popertoelpoperon/llavero-oled/piezas/1_carcasa/carcasa.stl

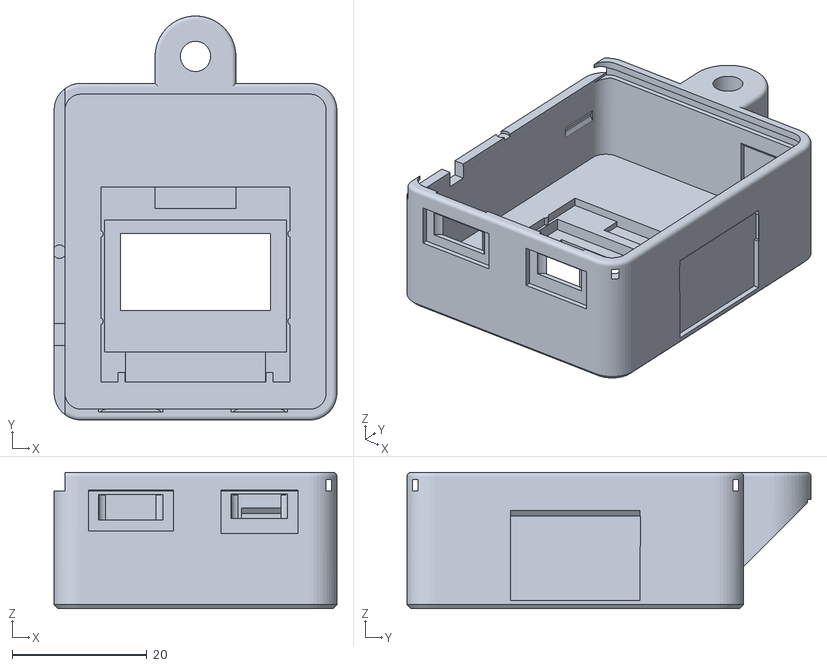
[picture p14: CAD file, 2026-11-11]
piezas/1_carcasa/carcasa.stl
42.0 x 60.0 x 20.2
