popertoelpoperon/llavero-oled/piezas/2_chasis/chasis.stl

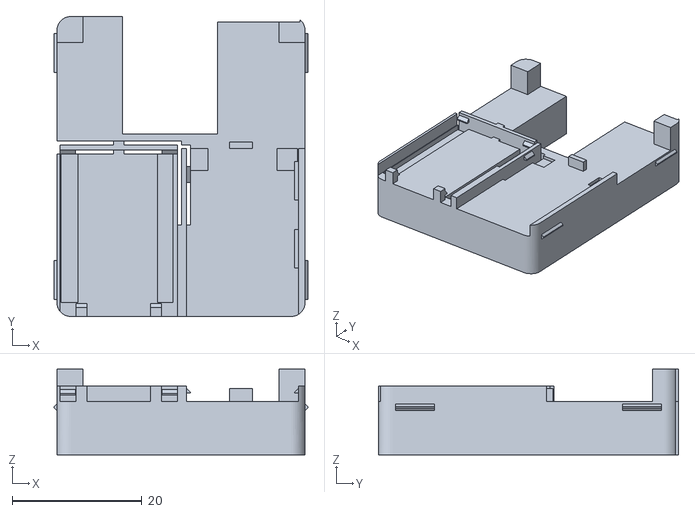
[picture p15: CAD file, 2026-11-11]
piezas/2_chasis/chasis.stl
39.2 x 46.3 x 13.2
