popertoelpoperon/llavero-oled/piezas/3_tapa/tapa_base.stl

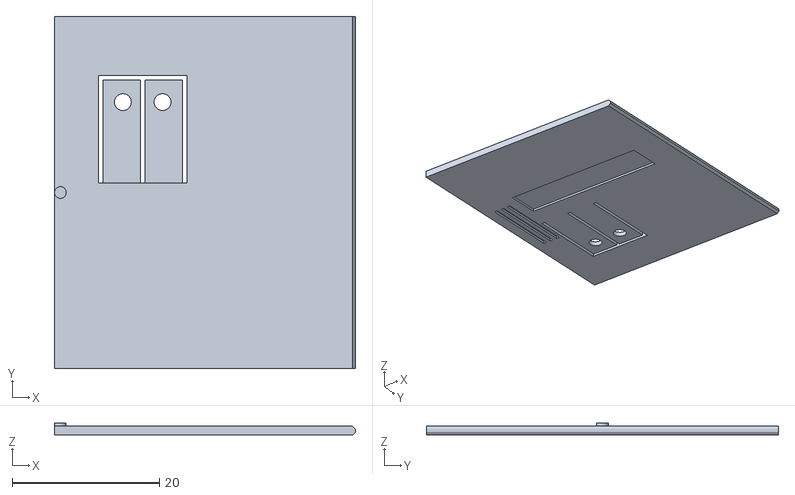
[picture p16: CAD file, 2026-11-11]
piezas/3_tapa/tapa_base.stl
40.9 x 47.9 x 1.65
