popertoelpoperon/llavero-oled/piezas/4_medallon_logo/disco_blanco.stl

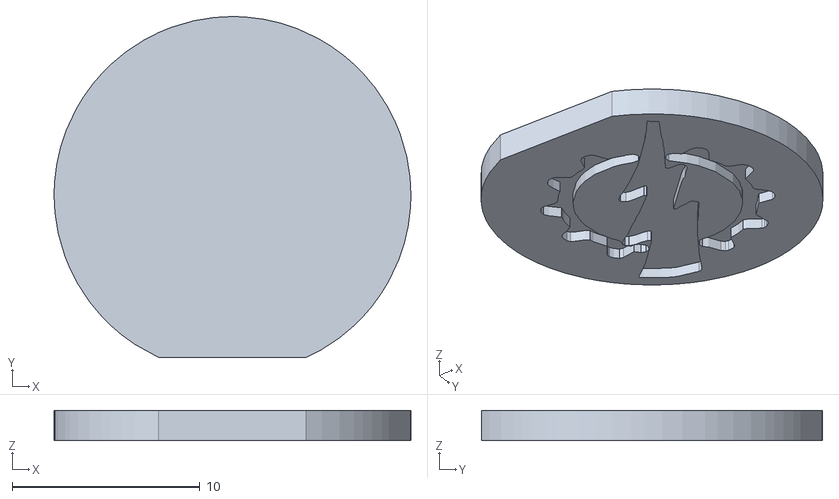
[picture p17: CAD file, 2026-11-11]
piezas/4_medallon_logo/disco_blanco.stl
19.0 x 18.2 x 1.60
