popertoelpoperon/llavero-oled/piezas/5_costado_derecho/placa.stl

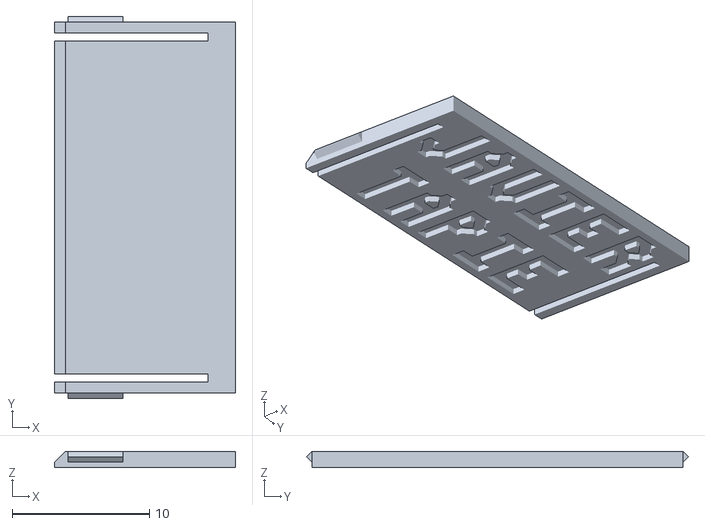
[picture p18: CAD file, 2026-11-11]
piezas/5_costado_derecho/placa.stl
13.2 x 27.8 x 1.20
