popertoelpoperon/llavero-oled/piezas/6_costado_izquierdo/texto_blanco.stl

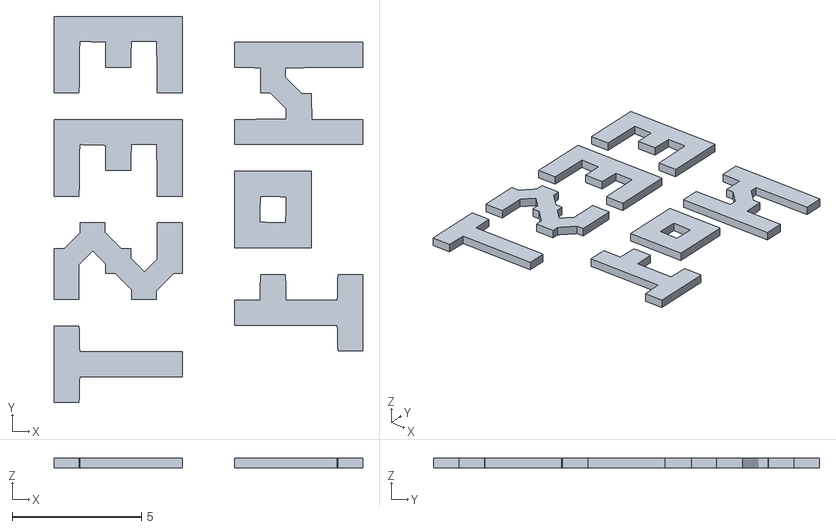
[picture p19: CAD file, 2026-11-11]
piezas/6_costado_izquierdo/texto_blanco.stl
12.0 x 15.0 x 0.4
