popertoelpoperon/llavero-oled/piezas/7_botones/cara_azul.stl

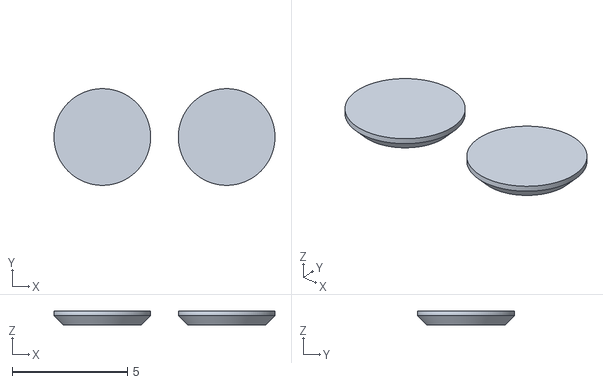
[picture p20: CAD file, 2026-11-11]
piezas/7_botones/cara_azul.stl
9.60 x 4.20 x 0.6
