popertoelpoperon/llavero-oled/piezas/4_medallon_logo/rayo.stl

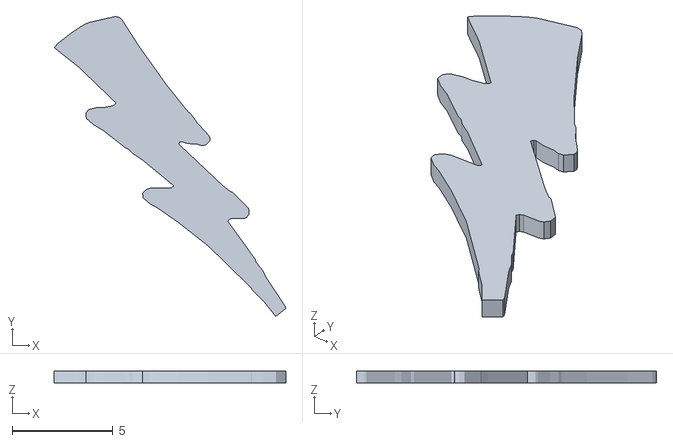
[picture p21: CAD file, 2026-11-11]
piezas/4_medallon_logo/rayo.stl
11.5 x 14.9 x 0.6
