popertoelpoperon/llavero-oled/piezas/5_costado_derecho/texto_blanco.stl

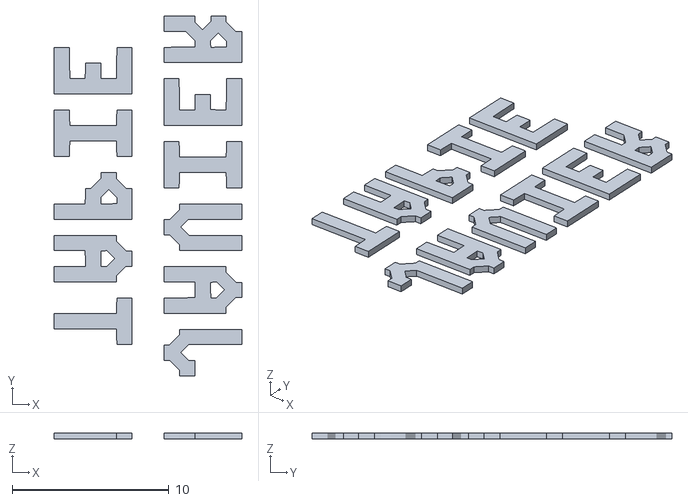
[picture p22: CAD file, 2026-11-11]
piezas/5_costado_derecho/texto_blanco.stl
12.0 x 23.0 x 0.4
