popertoelpoperon/llavero-oled/piezas/6_costado_izquierdo/placa.stl

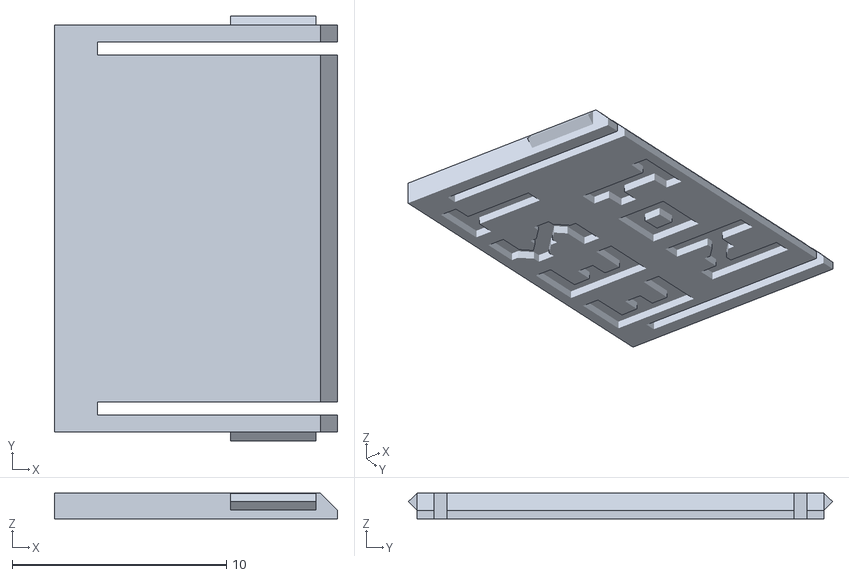
[picture p23: CAD file, 2026-11-11]
piezas/6_costado_izquierdo/placa.stl
13.2 x 19.8 x 1.20
