popertoelpoperon/llavero-oled/piezas/7_botones/botones.stl

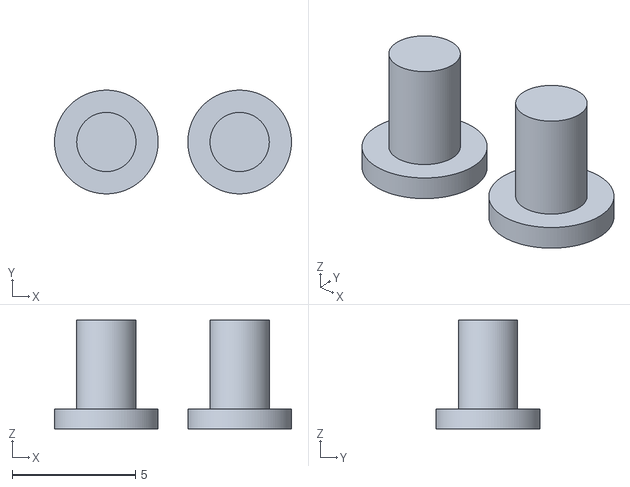
[picture p24: CAD file, 2026-11-11]
piezas/7_botones/botones.stl
9.60 x 4.20 x 4.40
