popertoelpoperon/llavero-oled/piezas/4_medallon_logo/engranaje_azul.stl

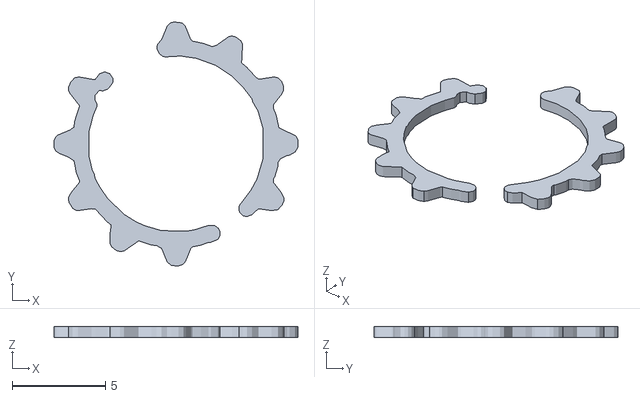
[picture p25: CAD file, 2026-11-11]
piezas/4_medallon_logo/engranaje_azul.stl
13.1 x 13.1 x 0.6
