popertoelpoperon/llavero-oled/(commit log)

2026-11-11 Llavero OLED: configurador web
    [botones.stl, cara_azul.stl, carcasa.stl, chasis.stl, disco_blanco.stl, engranaje_azul.stl, placa.stl, rayo.stl]
2026-11-11 Descargas, guía de armado y cafecito
